nabovarme/MeterLoggerPCB/kamstrup-wifi+power print bottom.pdf

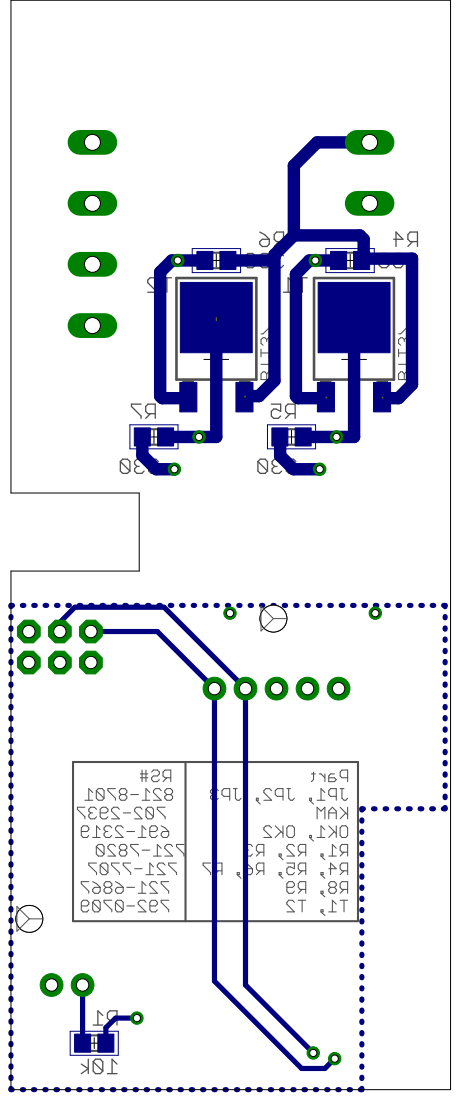
[picture p2: page 1]
