nabovarme/MeterLoggerPCB/kamstrup-wifi+power print top.pdf

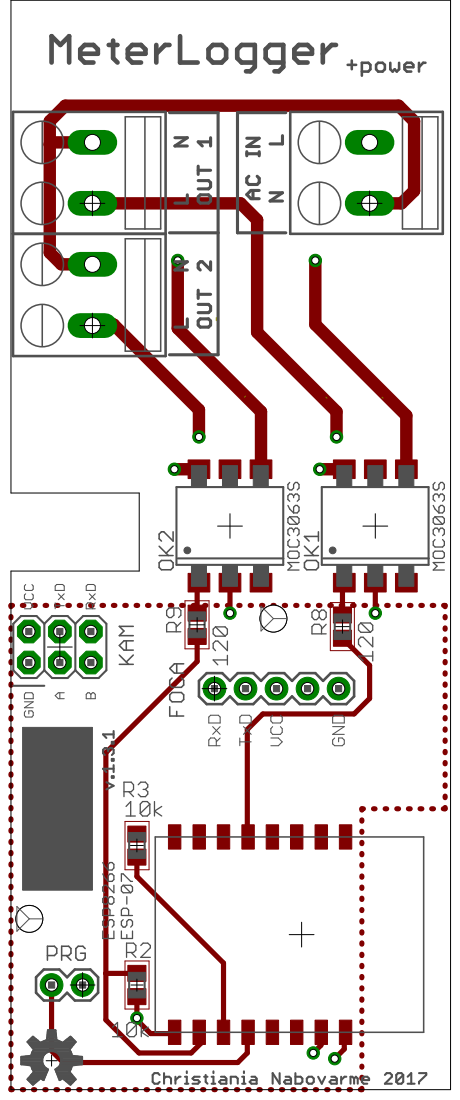
[picture p3: page 1]
