nabovarme/MeterLoggerPCB/kamstrup-wifi+power print.pdf

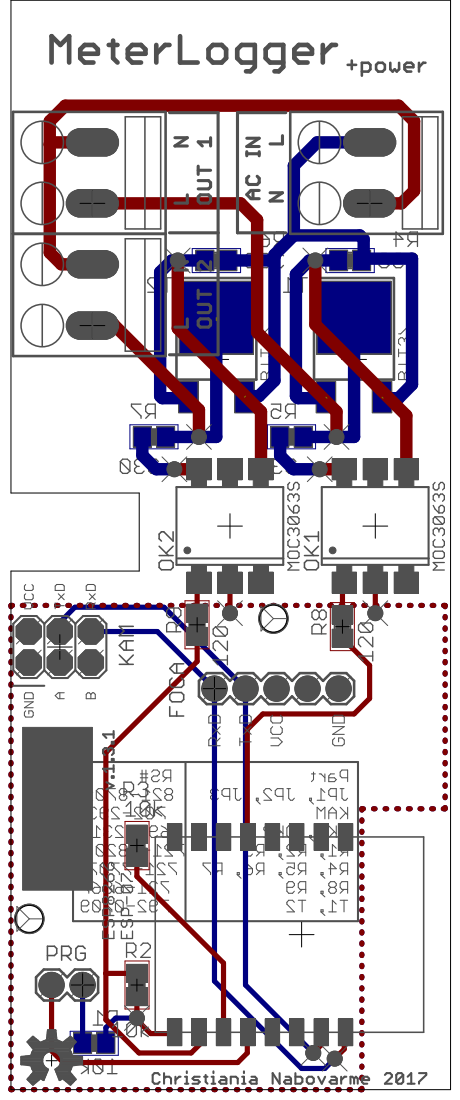
[picture p4: page 1]
