nabovarme/MeterLoggerPCB/kamstrup-wifi+power diagram.pdf

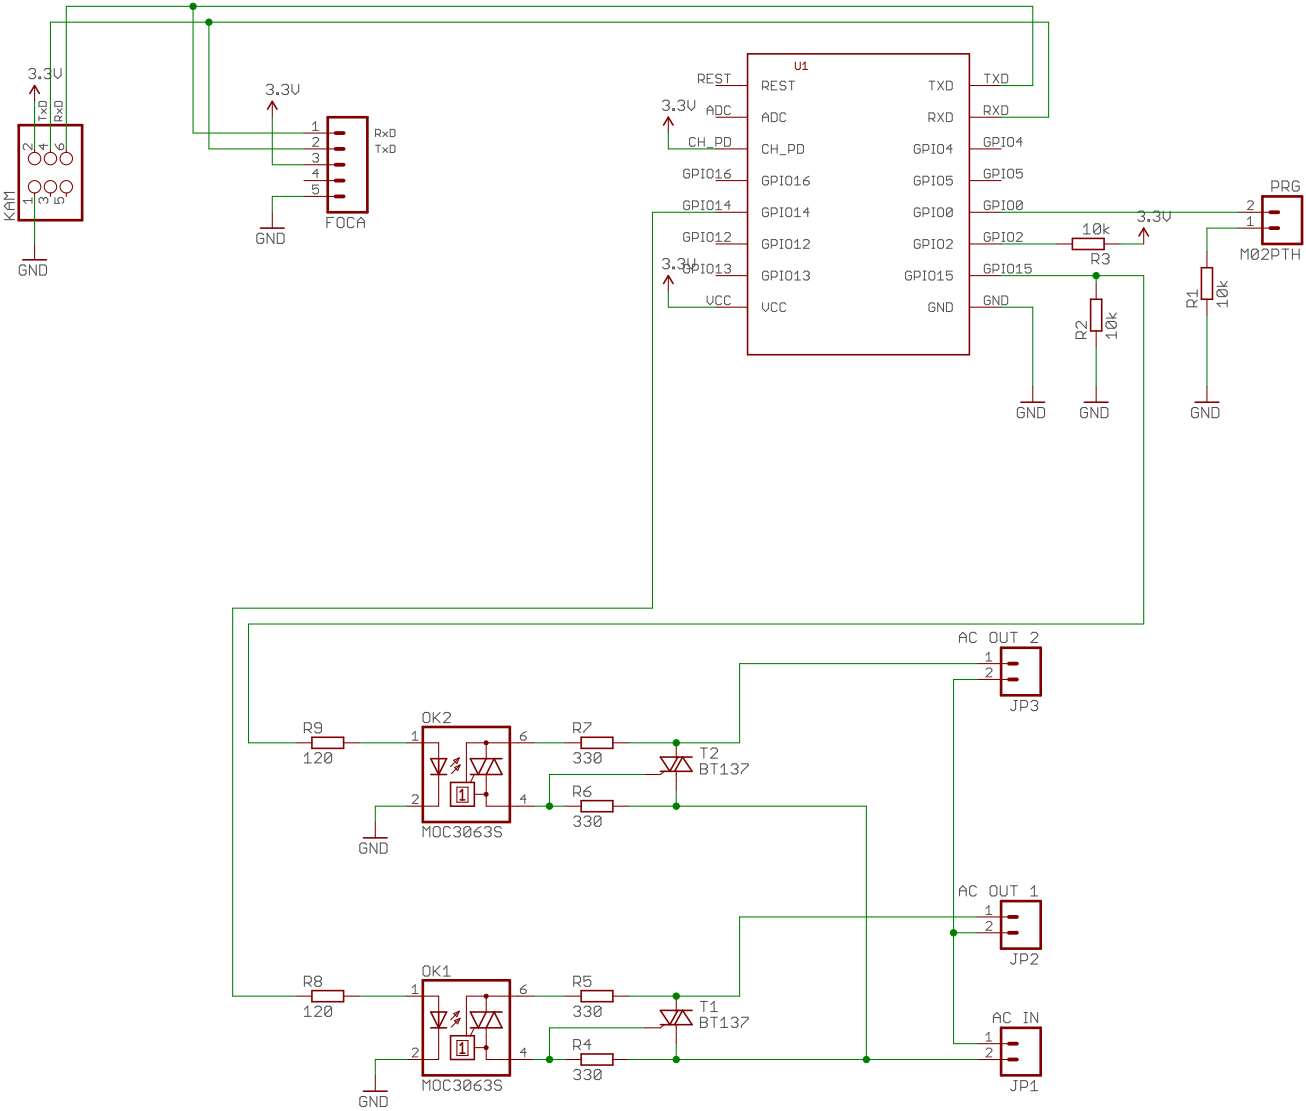
[picture p5: page 1]
