nabovarme/MeterLoggerPCB/kamstrup-wifi.brd

## EAGLE design kamstrup-wifi.brd (2018-05-11)

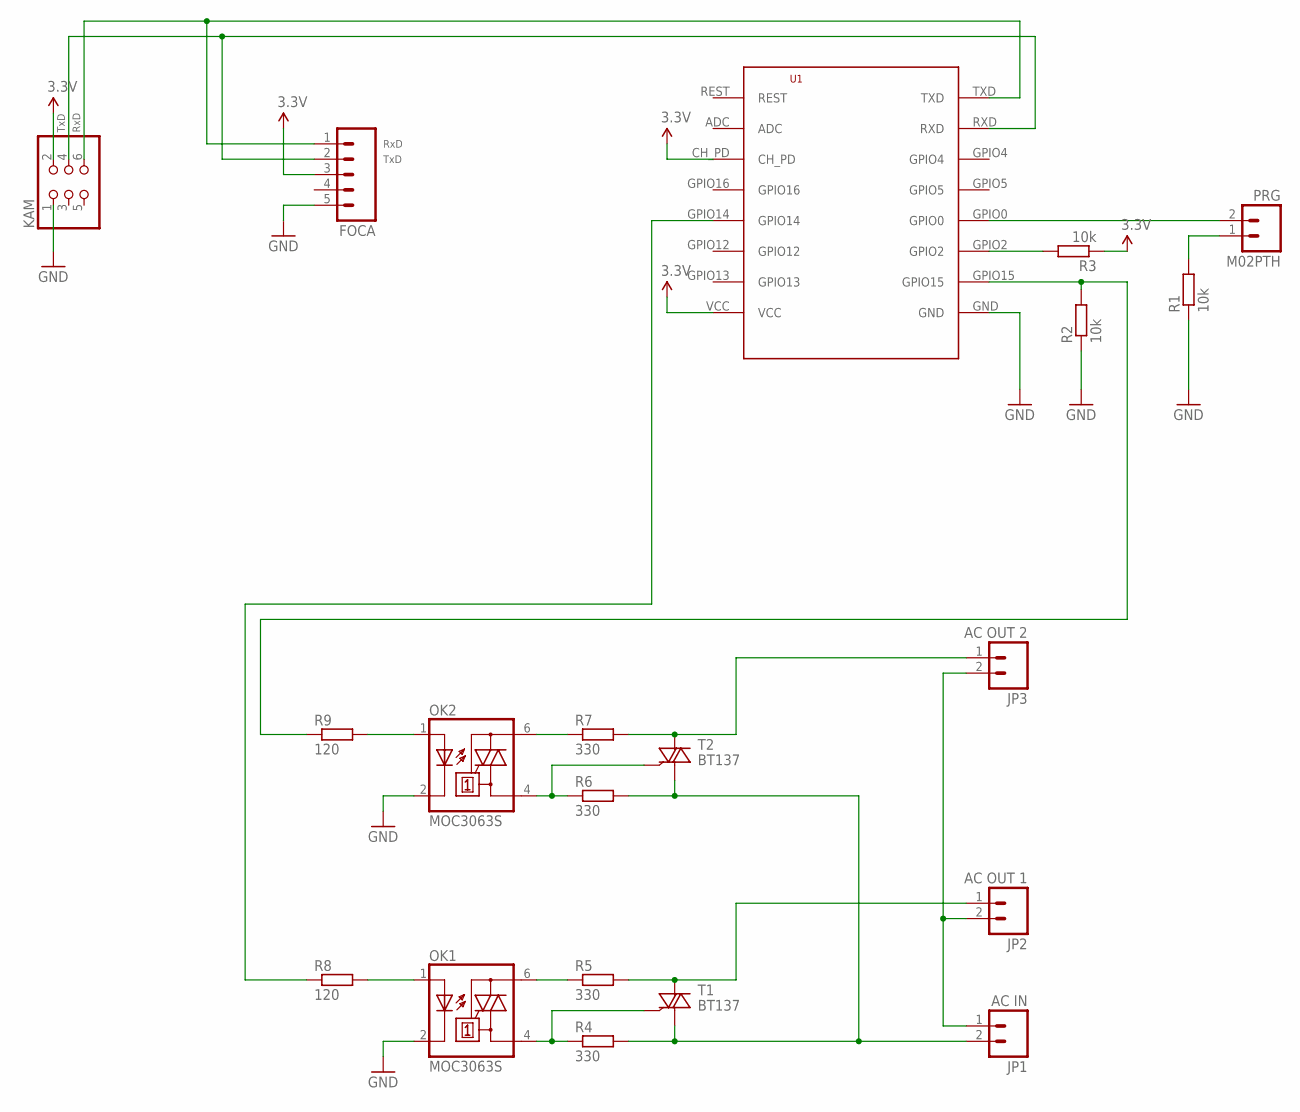
[picture p6: schematic kamstrup-wifi.sch]

Parts:
FOCA: M05PTH; 1X05
JP1: AC IN; SCREWTERMINAL-5MM-2
JP2: AC OUT 1; SCREWTERMINAL-5MM-2
JP3: AC OUT 2; SCREWTERMINAL-5MM-2
KAM: PINHD-2X3; 2X03
OK1, OK2: MOC3063S; DIL6-SMD
PRG: M02PTH; 1X02
R1, R2, R3: 10k; R0805
R4, R5, R6, R7: 330; R0805
R8, R9: 120; R0805
T1, T2: BT137; SOT428
U1: ESP8266-07; ESP-07

Connections:
3.3V: FOCA.3, KAM.2, R3.1, U1.CH_PD, U1.VCC
GND: FOCA.5, KAM.1, OK1.2 (C), OK2.2 (C), R1.1, R2.1, U1.GND
unnamed: FOCA.1, KAM.6, U1.TXD
unnamed: FOCA.2, KAM.4, U1.RXD
unnamed: PRG.2, U1.GPIO0
unnamed: PRG.1, R1.2
unnamed: OK2.1 (A), R9.2
unnamed: OK2.4 (A1), R6.1, T2.3 (G)
unnamed: OK2.6 (A2), R7.1
unnamed: JP3.1, R7.2, T2.4 (A2)
unnamed: JP1.2, R4.2, R6.2, T1.1 (A1), T2.1 (A1)
unnamed: R8.1, U1.GPIO14
unnamed: OK1.1 (A), R8.2
unnamed: OK1.4 (A1), R4.1, T1.3 (G)
unnamed: OK1.6 (A2), R5.1
unnamed: JP2.1, R5.2, T1.4 (A2)
unnamed: R2.2, R9.1, U1.GPIO15
unnamed: JP1.1, JP2.2, JP3.2
unnamed: R3.2, U1.GPIO2

Notes on the sheet:
RxD
TxD

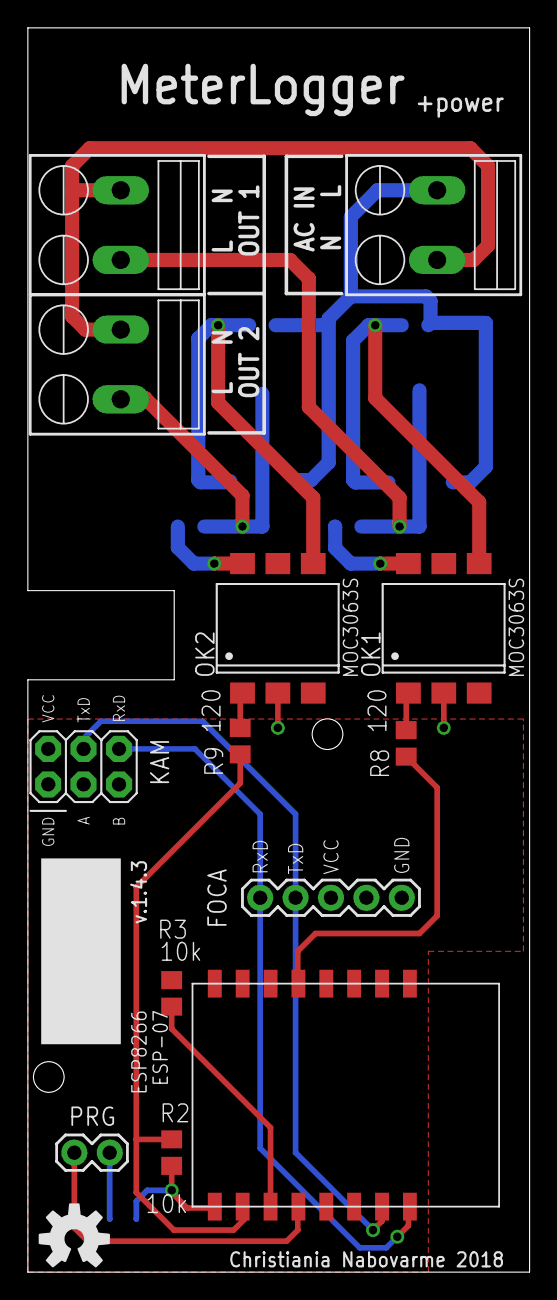
[picture p7: board kamstrup-wifi.brd from above]

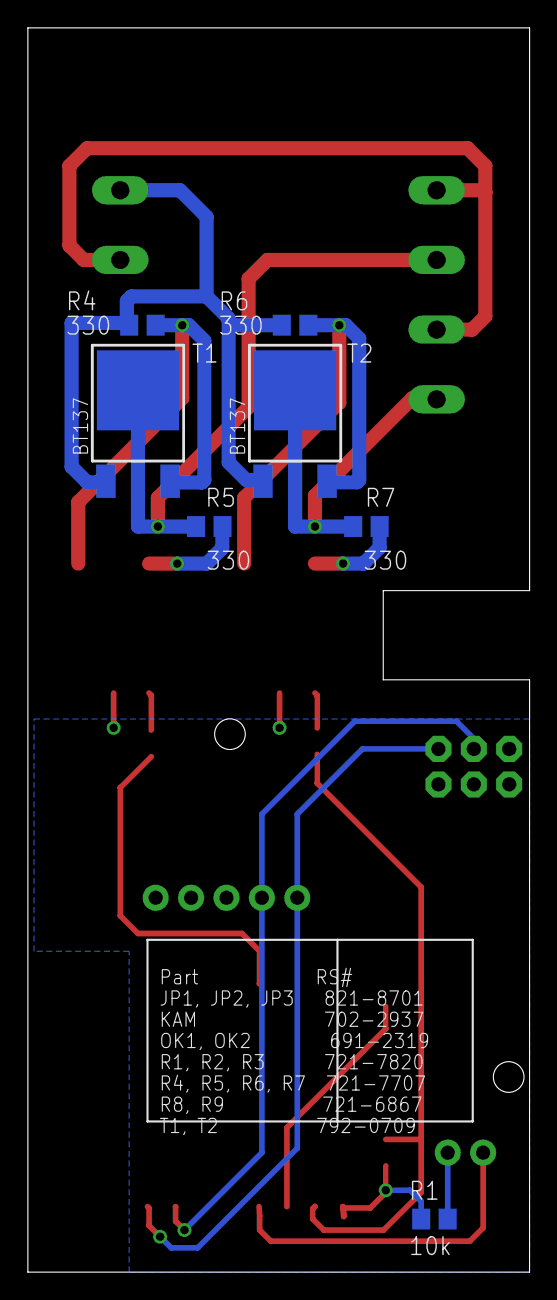
[picture p8: board kamstrup-wifi.brd from below]

Board: 2 copper layers, 36.0 x 89.3 mm, 21 parts (7 on the bottom side), 19 nets.

Other parts of the board:
U$2: OSHW-LOGO-M
