nabovarme/MeterLoggerPCB/psu/psu.brd

## EAGLE design psu/psu.brd (2018-04-28)

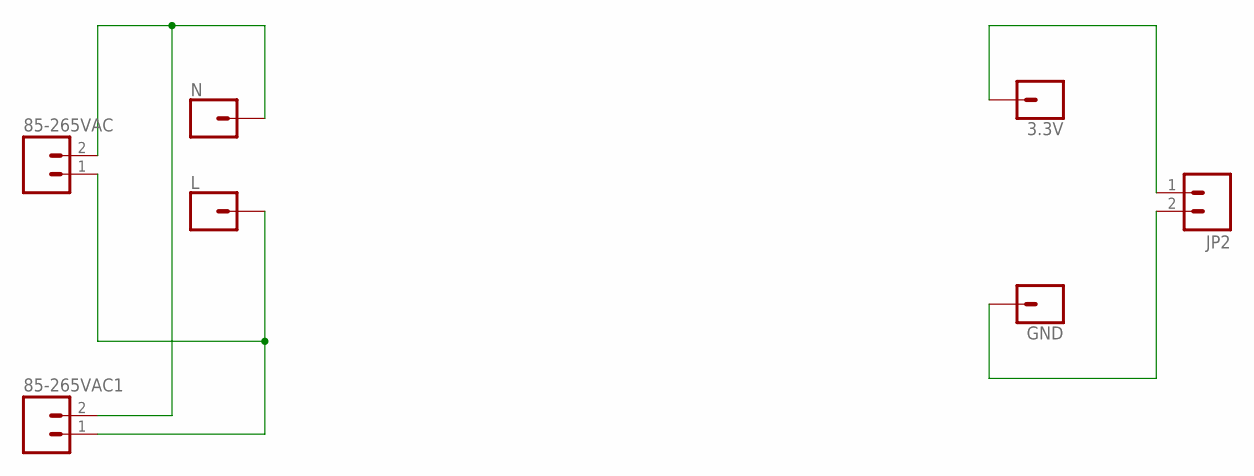
[picture p9: schematic psu.sch]

Parts:
3.3V: CONN_01PTH_1.4MM; 1X01_1.4MM
85-265VAC, 85-265VAC1: M02PTH3_5MM; 1X02_LONGPADS
GND: CONN_01PTH_1.4MM; 1X01_1.4MM
JP2: M02PTH3_5MM; 1X02_LONGPADS
L: CONN_01PTH_1.4MM; 1X01_1.4MM
N: CONN_01PTH_1.4MM; 1X01_1.4MM

Connections:
unnamed: 85-265VAC.1, 85-265VAC1.1, L.1
unnamed: 85-265VAC.2, 85-265VAC1.2, N.1
unnamed: 3.3V.1, JP2.1
unnamed: GND.1, JP2.2

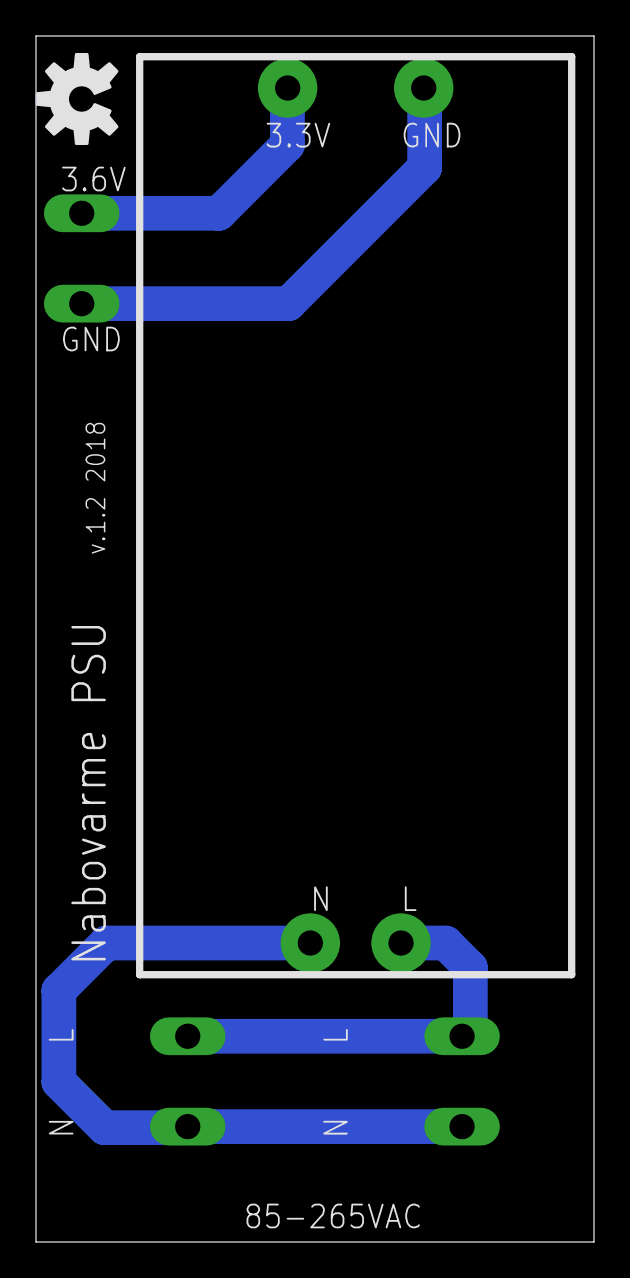
[picture p10: board psu.brd from above]

Board: 2 copper layers, 31.0 x 67.0 mm, 8 parts (0 on the bottom side), 4 nets.

Other parts of the board:
U$1: OSHW-LOGO-M
