nabovarme/MeterLoggerPCB/(commit log)

2015-09-15 added pcb+power from f81b98b96438f6aeb28dbc087c39275dec301eaf
    [kamstrup-wifi.brd, kamstrup-wifi.sch]
2016-05-18 v.1.2.1
    + watchdog and pulldown on gpio 15
    [kamstrup-wifi.brd, kamstrup-wifi.sch]
2016-05-29 PCB: v.1.4.1 Added FeRAM
    + docs
2016-11-19 added pull up resistor on GPIO02
    [kamstrup-wifi.brd, kamstrup-wifi.sch]
2017-04-21 added missing pull down (R12) on pcb
    [kamstrup-wifi.brd, kamstrup-wifi.sch]
2017-04-23 reverted pcb to v 1.2.1 2377baf1af9bc101ab4e1265beb616f56084d54c no pull down needed
    [kamstrup-wifi.brd, kamstrup-wifi.sch]
2017-10-08 Labels for N and L on AC in/out
    [kamstrup-wifi.brd, kamstrup-wifi.sch]
2017-10-09 pcb board made 8 mm higher for better fixation in kamstrup meter
    [kamstrup-wifi.brd]
2017-10-17 updated pdf's
    for schematics and pcb
2017-10-17 moved pcb/psu to pcb+power/psu
    [psu.brd, psu.sch]
2017-10-19 RS # for R4, R5, R8, R9 changed
    [kamstrup-wifi.brd]
2017-10-23 Missing R11 value fixed
    [kamstrup-wifi.brd]
2017-10-23 version bumbed to 1.2.5
    [kamstrup-wifi.brd]
2017-10-25 rotated jp1, jp3 and jp3
    [kamstrup-wifi.brd, kamstrup-wifi.sch]
2017-10-25 removed snubber circuits and external watchdog timer ic now version 1.3.0
    [kamstrup-wifi.brd, kamstrup-wifi.sch]
2017-10-25 changed some via size v 1.3.1
    [kamstrup-wifi.brd]
2018-04-27 updated psi pcb
    3.3V -> 3.6V
    v.1.1 -> v.1.2
    2015 -> 2018
    [psu.brd]
2018-04-28 psu pcb: smaller holes for psu module
    [psu.brd, psu.sch]
2018-04-28 psi pcb: better silk layout
    [psu.brd]
2018-05-09 programmer connector moved
    [kamstrup-wifi.brd]
2018-05-11 Silk updated
    [kamstrup-wifi.brd]
2018-05-11 Version sent to pcb fabrication
    [kamstrup-wifi.brd]
